aarz24/Paramaflood_Flutter/ESP Codes/ROADMAP_HARDWARE_ESPNOW_SERVO.md

# ParamaFlood Monitor — Panduan Pengembangan Lanjutan
## Arsitektur Dual ESP32 (ESP-NOW) & 4-Side Mechanical Servo Shutter

Dokumen ini disusun sebagai cetak biru (*blueprint*) teknis untuk implementasi perangkat keras tahap berikutnya menjelang presentasi lomba/sidang (2 bulan ke depan).

Silakan baca file utama di:
[ROADMAP_HARDWARE_ESPNOW_SERVO.md](file:///d:/IoT_KaryaAkhir_Flutter/weather-station-main/ROADMAP_HARDWARE_ESPNOW_SERVO.md)
