aarz24/Paramaflood_Flutter/Figure_1.4_System_Concept_Diagram.png

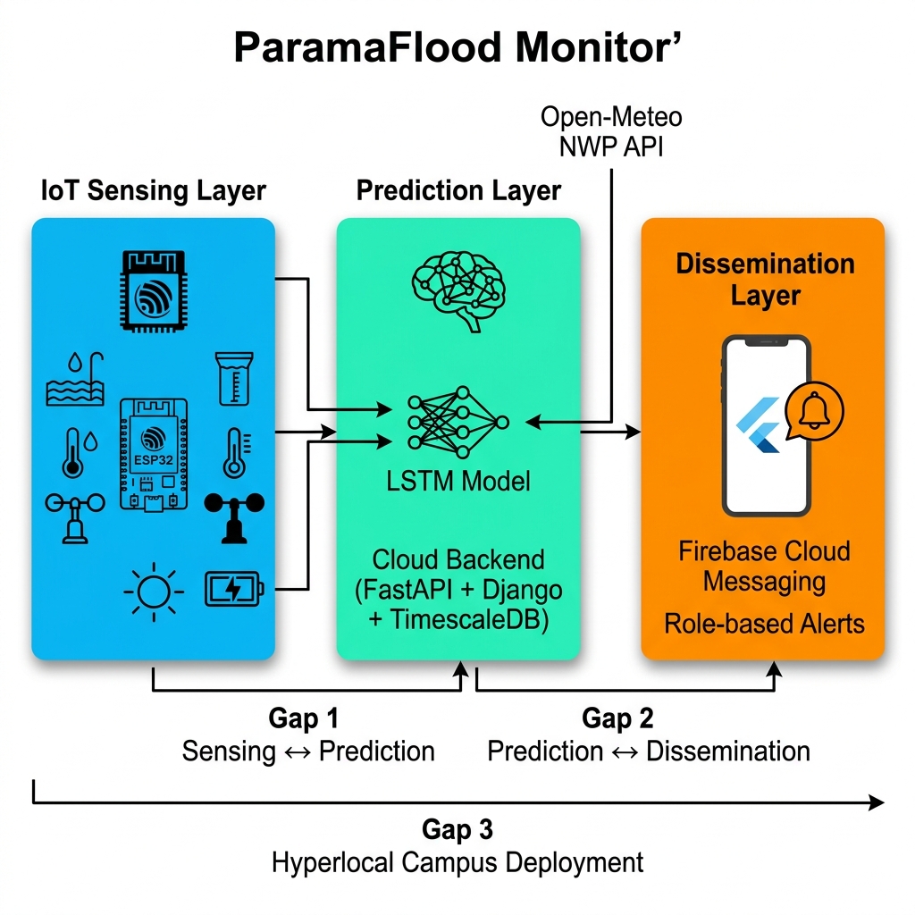
Figure_1.4_System_Concept_Diagram.png
