aarz24/Paramaflood_Flutter/(commit log)

2026-09-29 Riwayat: pill sensor selector, illustrated empty states; Indonesian settings labels
2026-09-29 Weather insight cards with icon badges and readable type; redesigned sensor-waiting banner
