aarz24/Paramaflood_Flutter/(notices)

Notices in the files:
README.md:
License: MIT
